Aminejb2002/minihex-9dof-motion-platform/docs/images/cad/exploded_lower_stage.png

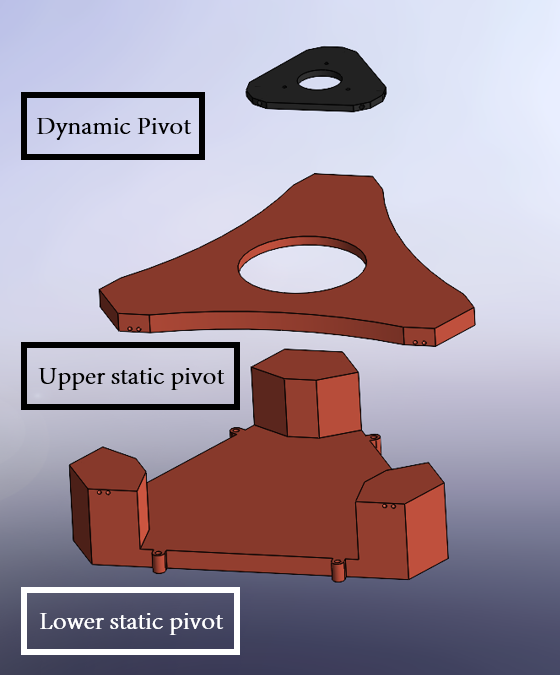
docs/images/cad/exploded_lower_stage.png
