Aminejb2002/minihex-9dof-motion-platform/docs/images/cad/lower_stage.png

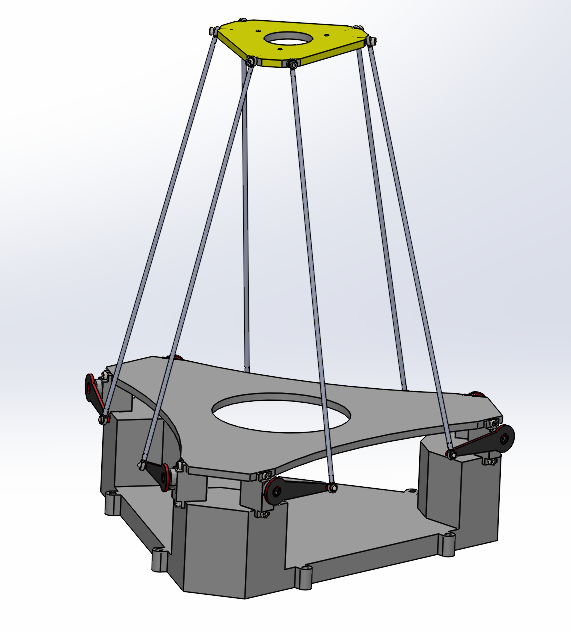
docs/images/cad/lower_stage.png
