Aminejb2002/minihex-9dof-motion-platform/docs/images/cad/servo_orientation_top_view.png

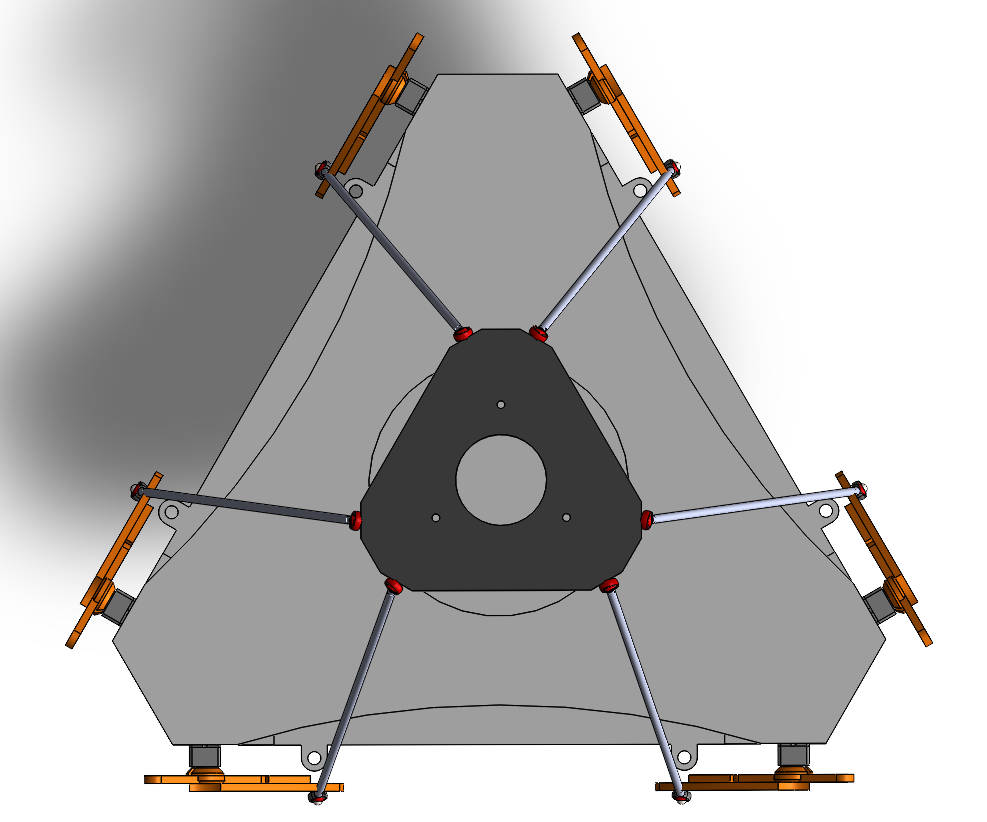
docs/images/cad/servo_orientation_top_view.png
