Aminejb2002/minihex-9dof-motion-platform/docs/images/cad/upper_stage_gimbal.png

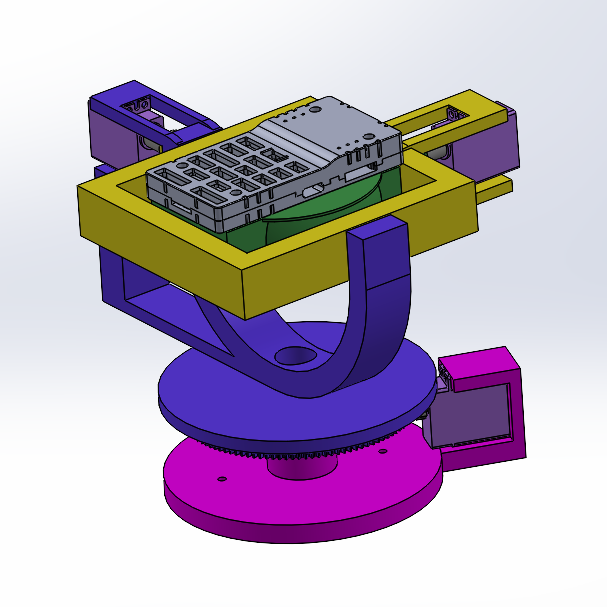
docs/images/cad/upper_stage_gimbal.png
