Aminejb2002/minihex-9dof-motion-platform/docs/images/simulation/rotation_error.png

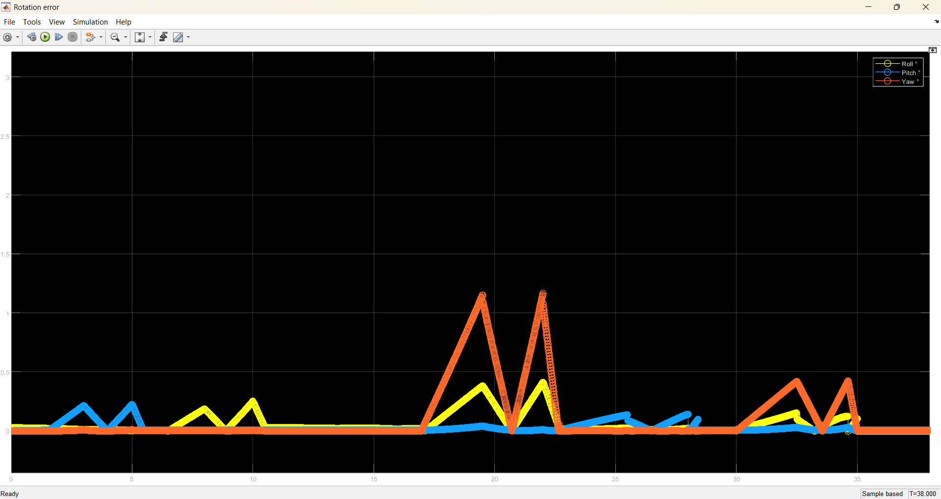
docs/images/simulation/rotation_error.png
