Aminejb2002/minihex-9dof-motion-platform/docs/images/simulation/simscape_full_model.png

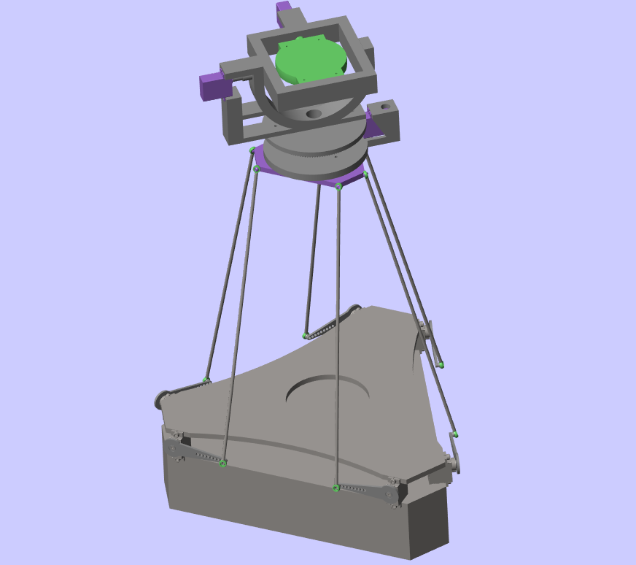
docs/images/simulation/simscape_full_model.png
