Aminejb2002/minihex-9dof-motion-platform/docs/images/simulation/simulink_top_level.png

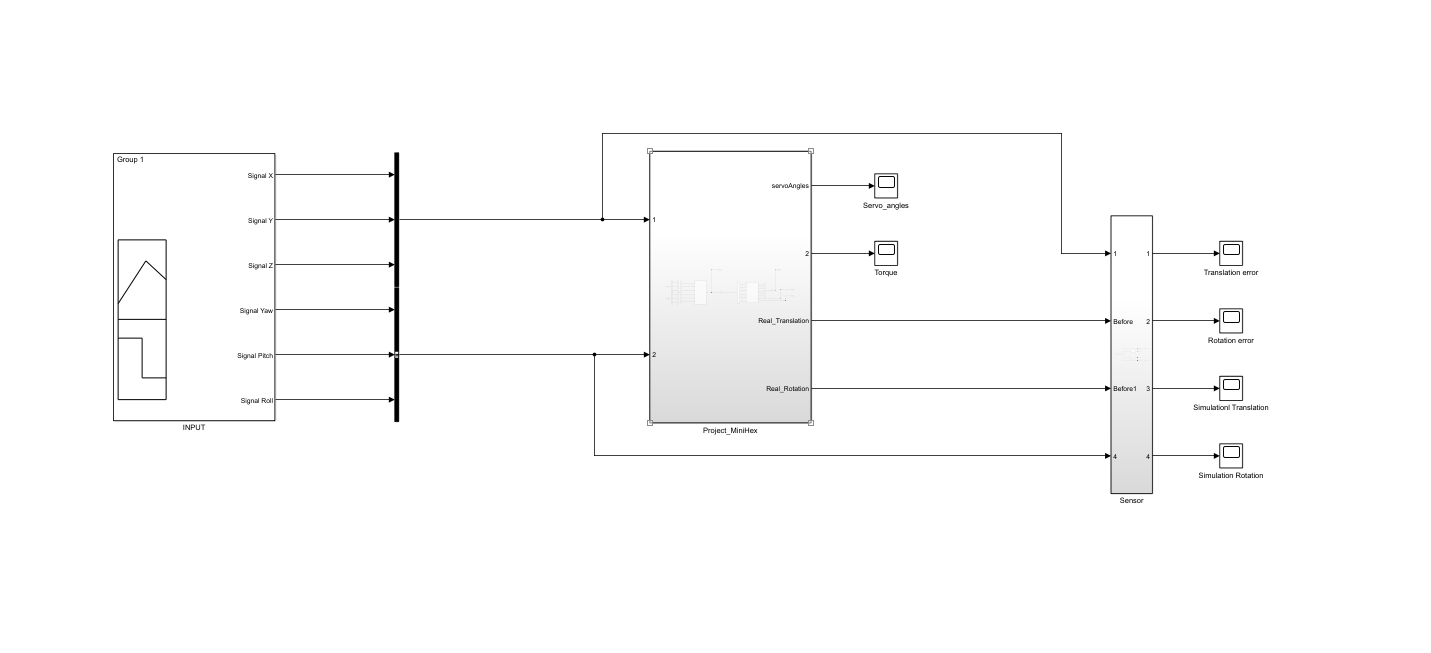
docs/images/simulation/simulink_top_level.png
