Aminejb2002/minihex-9dof-motion-platform/docs/images/simulation/translation_error.png

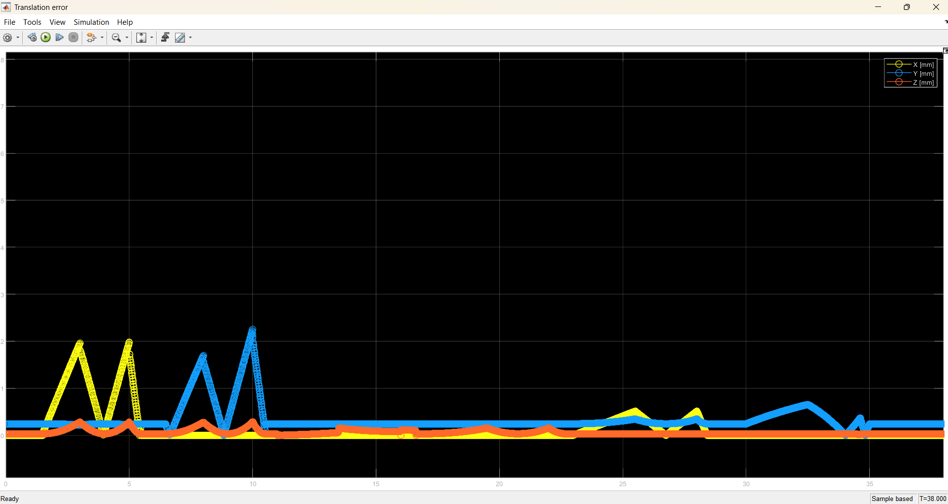
docs/images/simulation/translation_error.png
