Aminejb2002/minihex-9dof-motion-platform/docs/images/simulation/upper_stage_input_signals.png

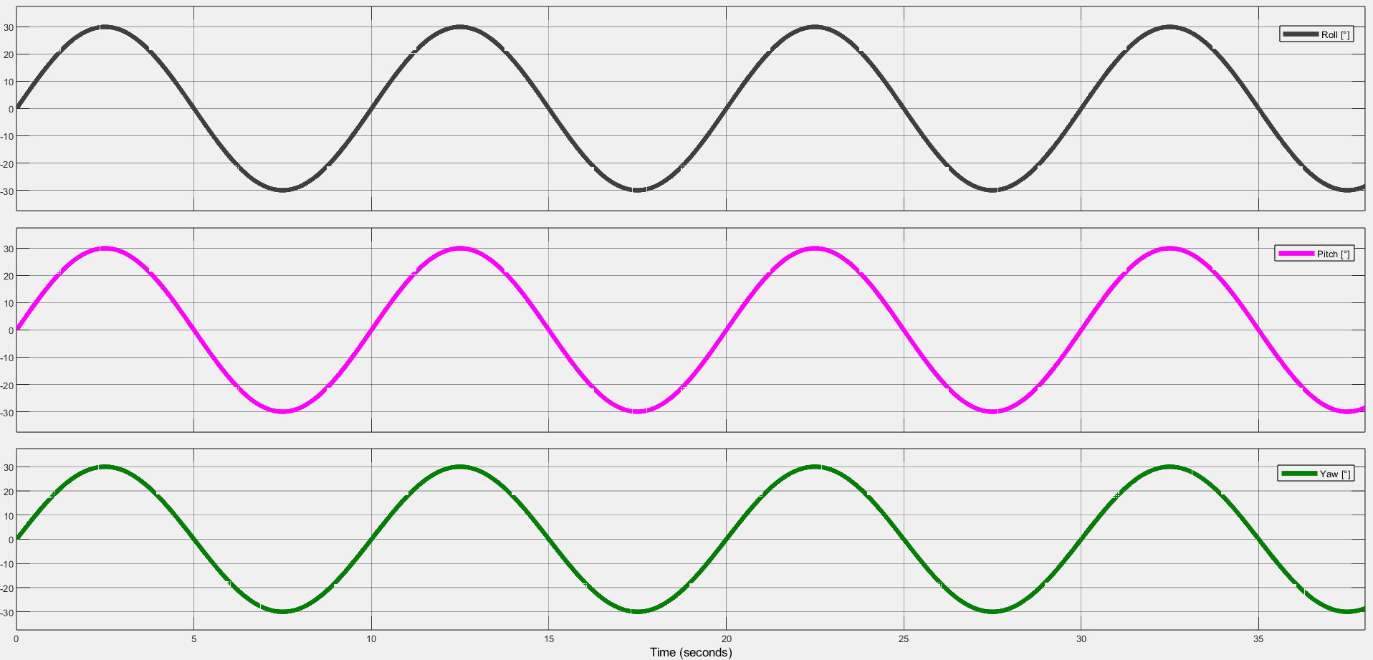
docs/images/simulation/upper_stage_input_signals.png
