Aminejb2002/minihex-9dof-motion-platform/docs/bill_of_parts.md

# Bill of parts

## Lower stage (Stewart platform)

| Part | Qty | Source |
|---|---|---|
| Static pivot, upper part | 1 | 3D printed |
| Static pivot, lower part | 1 | 3D printed |
| Dynamic pivot | 1 | 3D printed |
| Servo horn attachment | 6 | 3D printed |
| Ball joint M3 | 12 | purchased |
| Servo FrSky Xact Mini Servo HV M 5253H | 6 | purchased |
| Rod M3, 300 mm stainless threaded pushrod | 10 | purchased |
| Aluminium servo arm for FrSky Xact servo | 6 | purchased |
| Prusa threaded inserts M2 short | 100 | purchased |
| Prusa threaded inserts M3 standard | 100 | purchased |

## Upper stage (gimbal)

| Part | Qty | Source |
|---|---|---|
| Yaw ring, parts 1 and 2 | 1 each | 3D printed |
| Roll ring | 1 | 3D printed |
| Pitch ring, parts 1 and 2 | 1 each | 3D printed |
| Base plate, parts 1 and 2 | 1 each | 3D printed |
| Small gear for servo | 1 | 3D printed |
| Pixhawk 6C | 1 | purchased |
| Servo FrSky Xact Mini Servo HV M 5252H | 3 | purchased |
| Aluminium servo arm for FrSky Xact servo | 2 | purchased |
| Deep-groove ball bearing 61801 (12 × 21 × 5 mm), optional yaw bearing | 1 | purchased |
| Screws and nuts M2.5 and M3 | 2 each | purchased |

## Design parameters (lower stage)

| Parameter | Value |
|---|---|
| Static pivot diameter | 320 mm |
| Dynamic pivot diameter | 120 mm |
| Rod length | 308 mm |
| Rod diameter | 3 mm |
| Ball joint max. tilt | 20° |

The printable parts are in [`cad/printed_parts`](../cad/printed_parts). Some parts are split into several pieces to fit the print bed and to choose a good print orientation.
