Aminejb2002/minihex-9dof-motion-platform/simulation/simscape/SUB-ASSEMBLY static_pivot_Default_sldprt.STEP

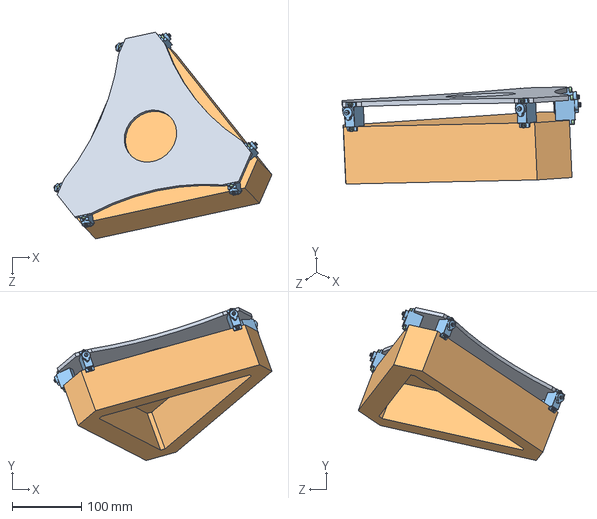
[picture p37: CAD file, 2026-10-01]
simulation/simscape/SUB-ASSEMBLY static_pivot_Default_sldprt.STEP
314.9 x 221.1 x 298.6 mm
