Aminejb2002/minihex-9dof-motion-platform/simulation/simscape/SUB-ASSEMBLY dynamic_pivot_Upper_only_Default_sldprt.STEP

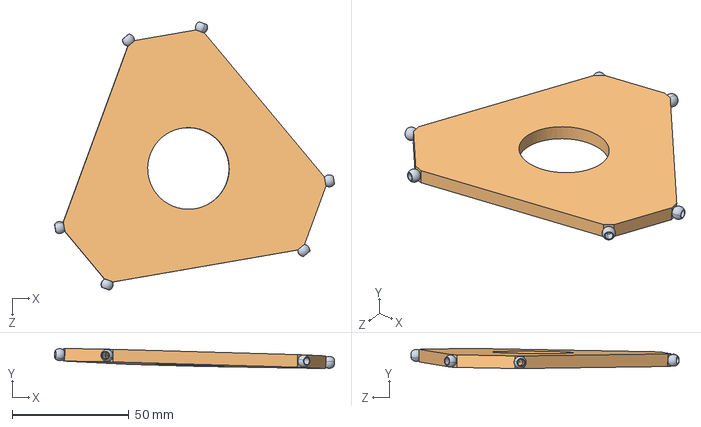
[picture p38: CAD file, 2026-10-01]
simulation/simscape/SUB-ASSEMBLY dynamic_pivot_Upper_only_Default_sldprt.STEP
120.0 x 8.62 x 115.0 mm
