Aminejb2002/minihex-9dof-motion-platform/simulation/simscape/ASSEMBLY_Horn_sphere_Default_sldprt.STEP

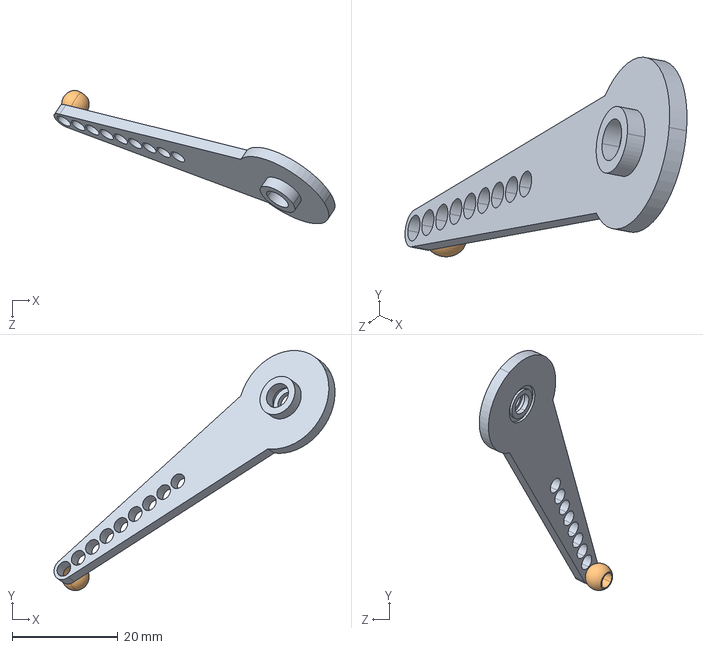
[picture p39: CAD file, 2026-10-01]
simulation/simscape/ASSEMBLY_Horn_sphere_Default_sldprt.STEP
53.1 x 45.4 x 25.2 mm
