Aminejb2002/minihex-9dof-motion-platform/cad/printed_parts/lower_stage/Static_Pivot_Lower_Part.3mf

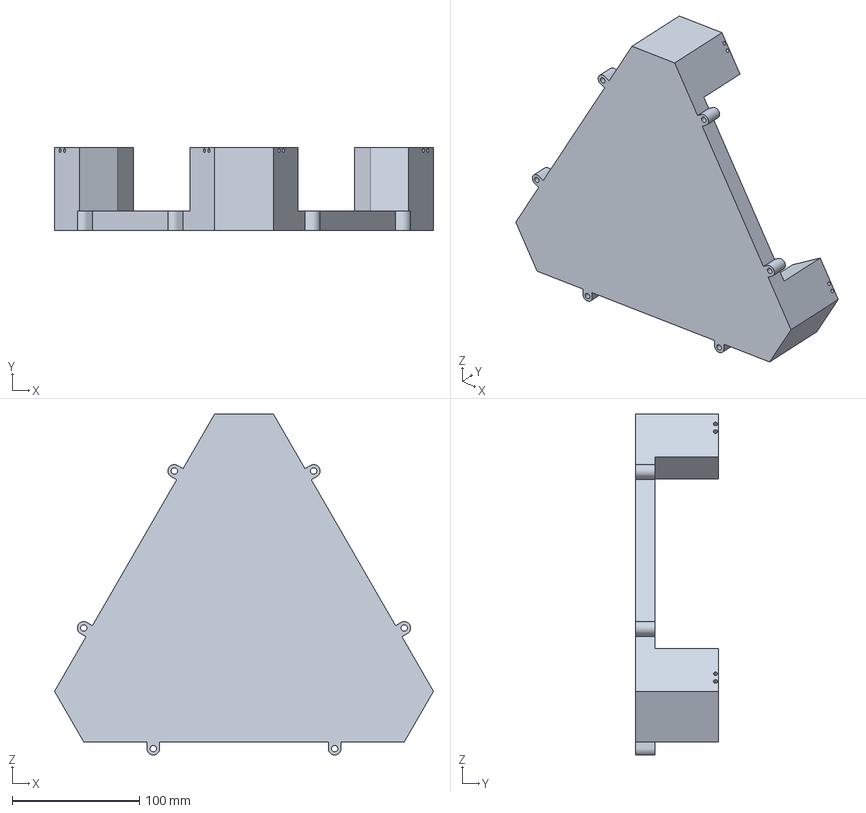
[picture p40: CAD file, 2026-10-01]
cad/printed_parts/lower_stage/Static_Pivot_Lower_Part.3mf
297.3 x 65.4 x 267.4 mm
