Aminejb2002/minihex-9dof-motion-platform/cad/printed_parts/upper_stage/Pitch_Ring_Part_1.3mf

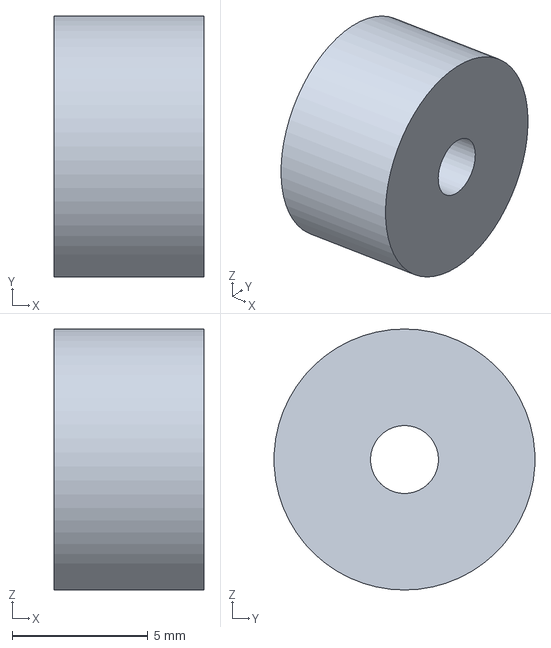
[picture p41: CAD file, 2026-10-01]
cad/printed_parts/upper_stage/Pitch_Ring_Part_1.3mf
5.50 x 9.59 x 9.60 mm
