Aminejb2002/minihex-9dof-motion-platform/cad/solidworks/lower_stage/servo_strong_junk_1.SLDPRT

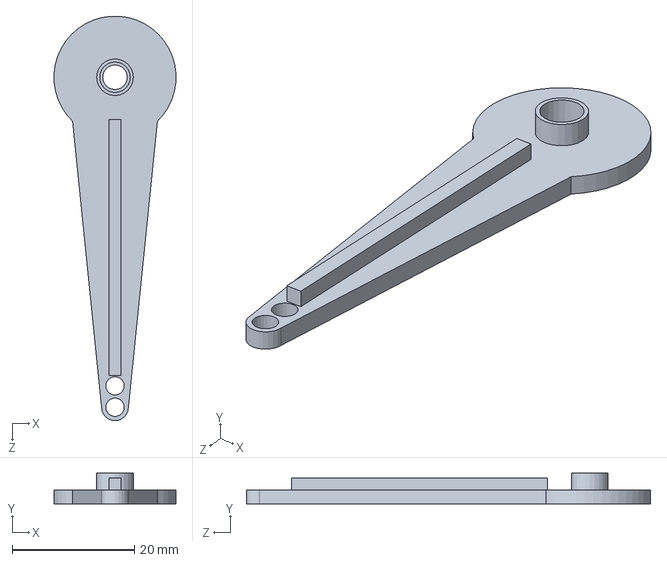
[picture p42: CAD file, 2026-10-01]
cad/solidworks/lower_stage/servo_strong_junk_1.SLDPRT
20.0 x 5.00 x 66.2 mm
