Aminejb2002/minihex-9dof-motion-platform/cad/solidworks/upper_stage/Base_Plate_Part_2.SLDPRT

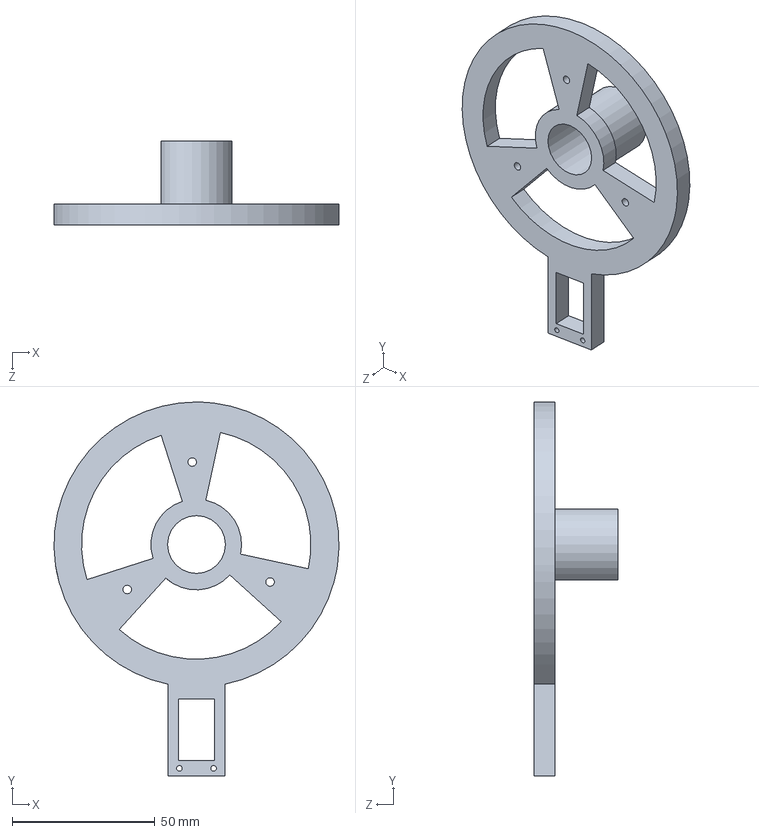
[picture p43: CAD file, 2026-10-01]
cad/solidworks/upper_stage/Base_Plate_Part_2.SLDPRT
100.0 x 131.2 x 29.4 mm
