Aminejb2002/minihex-9dof-motion-platform/cad/printed_parts/lower_stage/Static_Pivot_Upper_Part_Light_Version.3mf

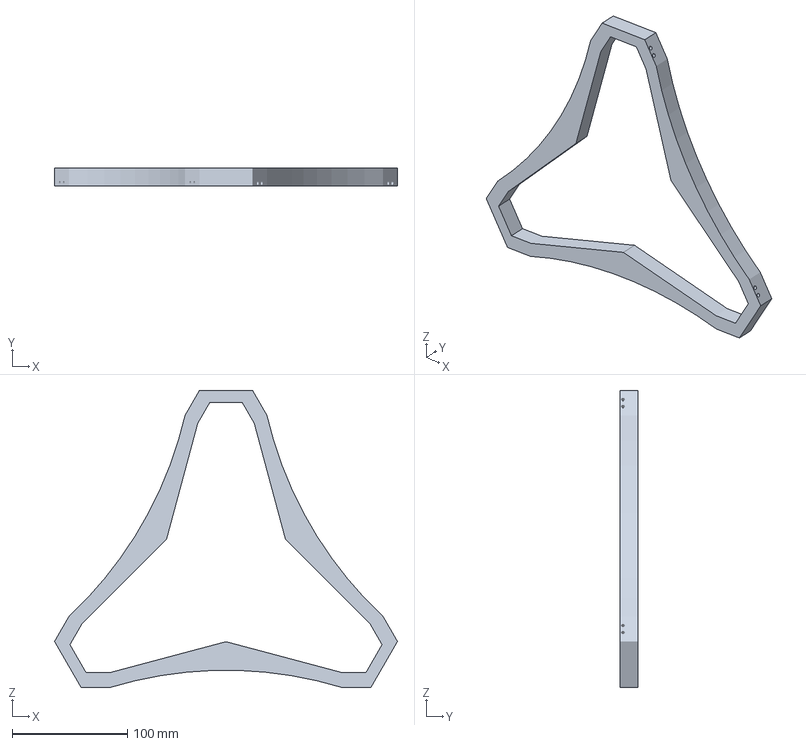
[picture p44: CAD file, 2026-10-01]
cad/printed_parts/lower_stage/Static_Pivot_Upper_Part_Light_Version.3mf
297.3 x 15.4 x 257.5 mm
