Aminejb2002/minihex-9dof-motion-platform/cad/printed_parts/upper_stage/Pitch_Ring_Part_2.3mf

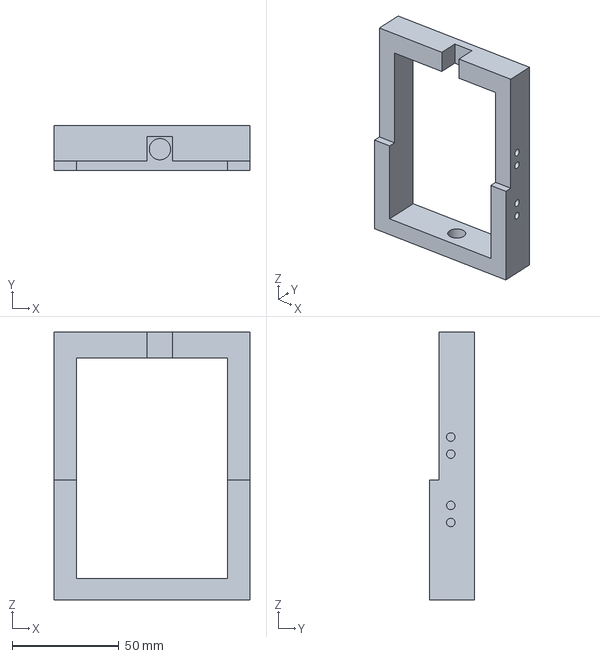
[picture p45: CAD file, 2026-10-01]
cad/printed_parts/upper_stage/Pitch_Ring_Part_2.3mf
91.6 x 21.1 x 125.4 mm
