Aminejb2002/minihex-9dof-motion-platform/cad/solidworks/lower_stage/Dynamic_Pivot.SLDPRT

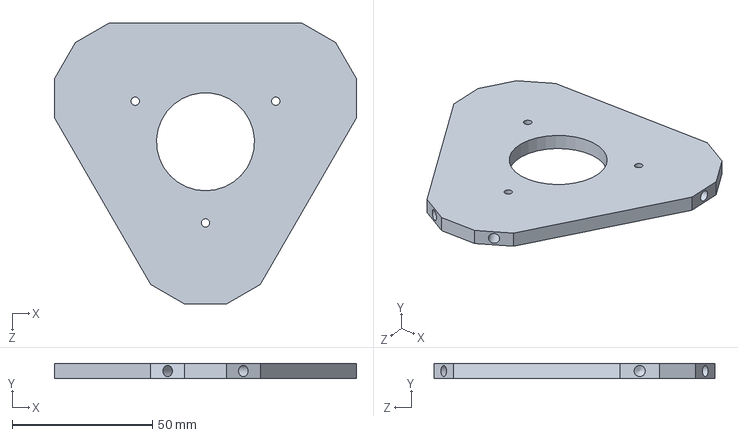
[picture p46: CAD file, 2026-10-01]
cad/solidworks/lower_stage/Dynamic_Pivot.SLDPRT
107.8 x 5.40 x 100.4 mm
