Aminejb2002/minihex-9dof-motion-platform/simulation/simscape/IMU-PIXHAWK6C.stp_Default_sldprt.STEP

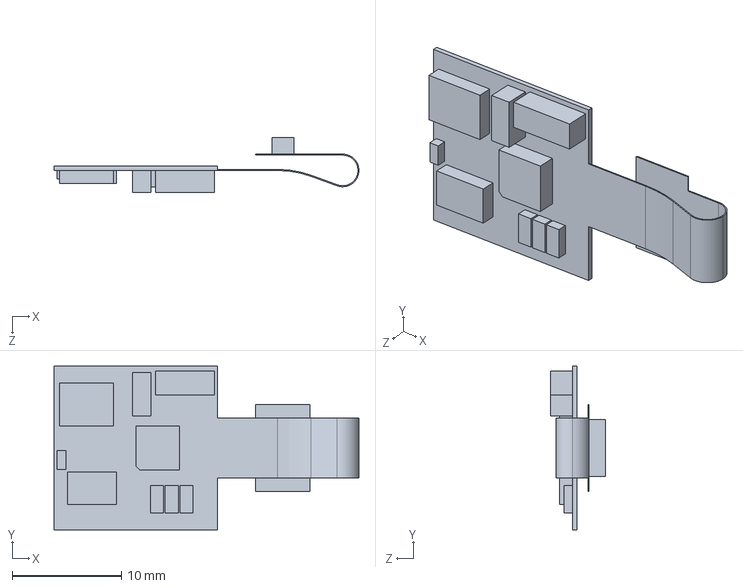
[picture p47: CAD file, 2026-10-01]
simulation/simscape/IMU-PIXHAWK6C.stp_Default_sldprt.STEP
28.0 x 15.0 x 5.00 mm
