Aminejb2002/minihex-9dof-motion-platform/cad/printed_parts/upper_stage/Roll_Ring.3mf

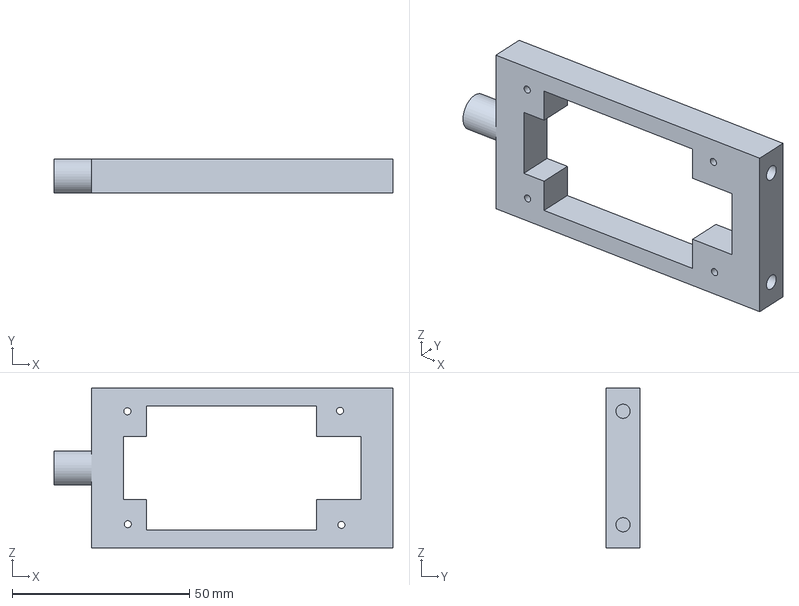
[picture p48: CAD file, 2026-10-01]
cad/printed_parts/upper_stage/Roll_Ring.3mf
95.6 x 9.60 x 45.0 mm
