Aminejb2002/minihex-9dof-motion-platform/cad/solidworks/lower_stage/Static_Pivot_Upper_Part.SLDPRT

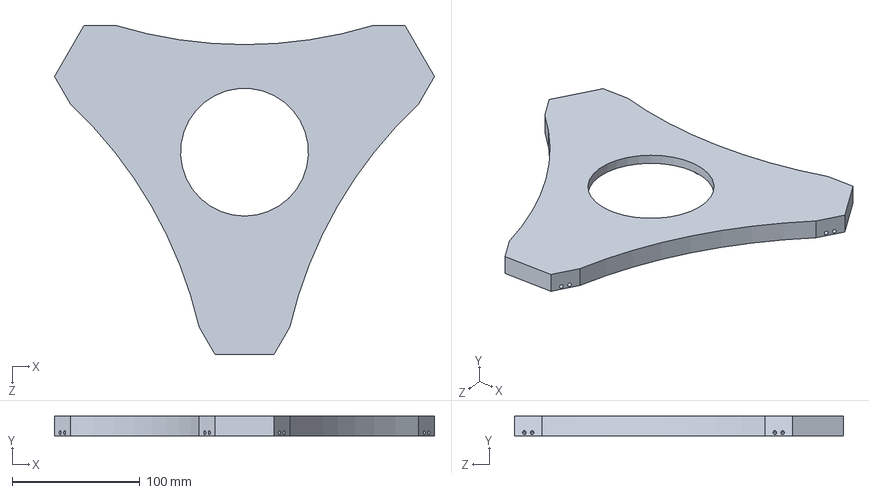
[picture p49: CAD file, 2026-10-01]
cad/solidworks/lower_stage/Static_Pivot_Upper_Part.SLDPRT
297.3 x 15.4 x 257.5 mm
