Aminejb2002/minihex-9dof-motion-platform/simulation/simscape/MIANKE-PIXHAWK6C-LV-C1.stp_Default_sldprt.STEP

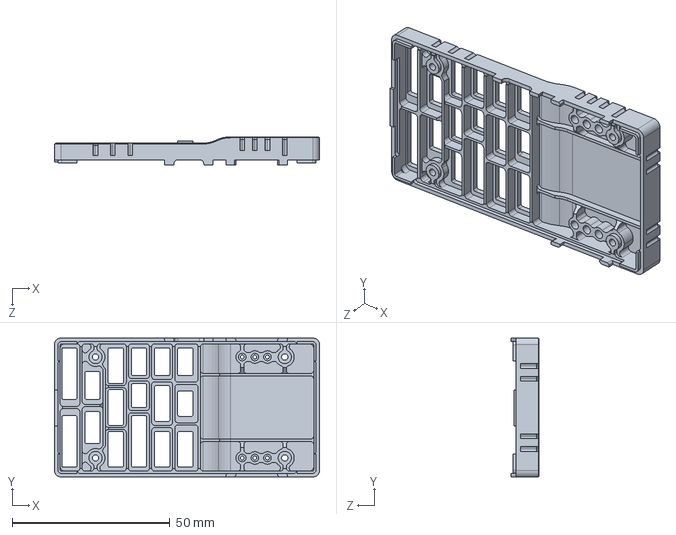
[picture p50: CAD file, 2026-10-01]
simulation/simscape/MIANKE-PIXHAWK6C-LV-C1.stp_Default_sldprt.STEP
84.0 x 44.0 x 9.00 mm
