Aminejb2002/minihex-9dof-motion-platform/cad/solidworks/upper_stage/Yaw_Ring_Part_1.SLDPRT

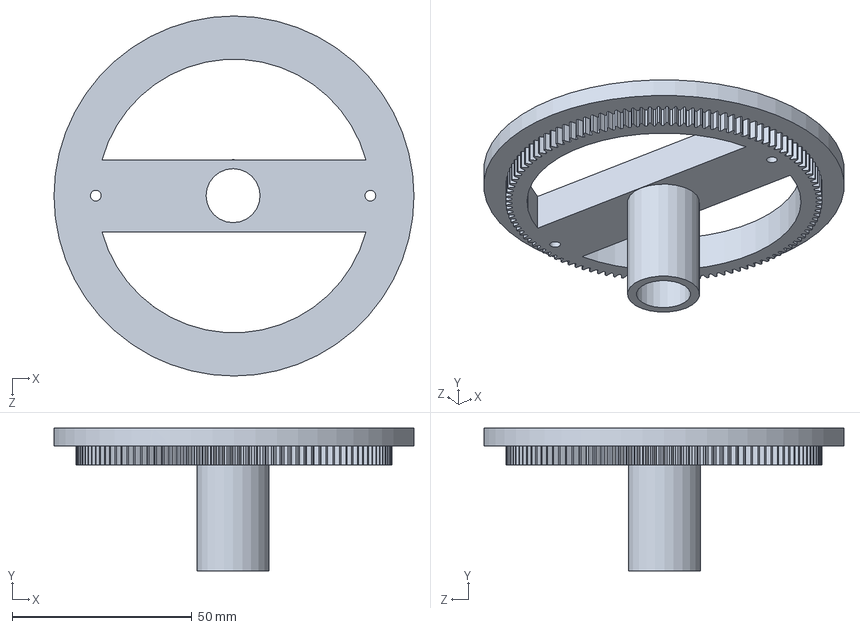
[picture p51: CAD file, 2026-10-01]
cad/solidworks/upper_stage/Yaw_Ring_Part_1.SLDPRT
100.0 x 39.6 x 100.0 mm
