Aminejb2002/minihex-9dof-motion-platform/simulation/simscape/Ball Joint 3mm outer sphere_Default_sldprt.STEP

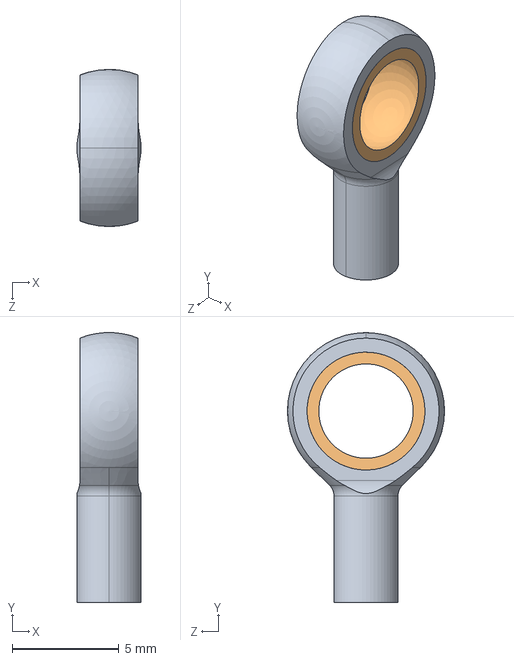
[picture p52: CAD file, 2026-10-01]
simulation/simscape/Ball Joint 3mm outer sphere_Default_sldprt.STEP
3.02 x 12.7 x 7.36 mm
