Aminejb2002/minihex-9dof-motion-platform/cad/printed_parts/lower_stage/Horn_Attachment.3mf

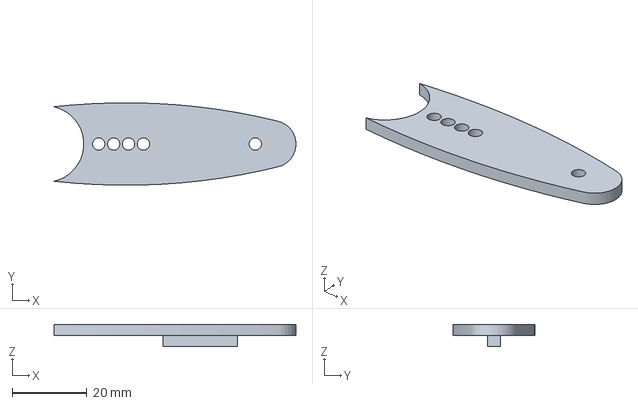
[picture p53: CAD file, 2026-10-01]
cad/printed_parts/lower_stage/Horn_Attachment.3mf
64.9 x 22.1 x 6.00 mm
