Aminejb2002/minihex-9dof-motion-platform/cad/printed_parts/upper_stage/Yaw_Ring_Part_2.3mf

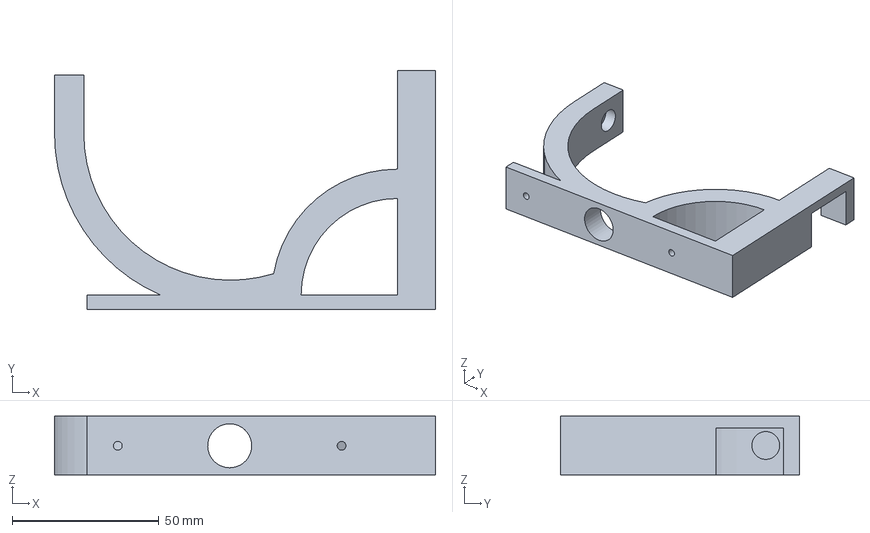
[picture p54: CAD file, 2026-10-01]
cad/printed_parts/upper_stage/Yaw_Ring_Part_2.3mf
129.9 x 81.5 x 20.0 mm
