Aminejb2002/minihex-9dof-motion-platform/simulation/simscape/Roll_Ring_Backup_Version_Default_sldprt.STEP

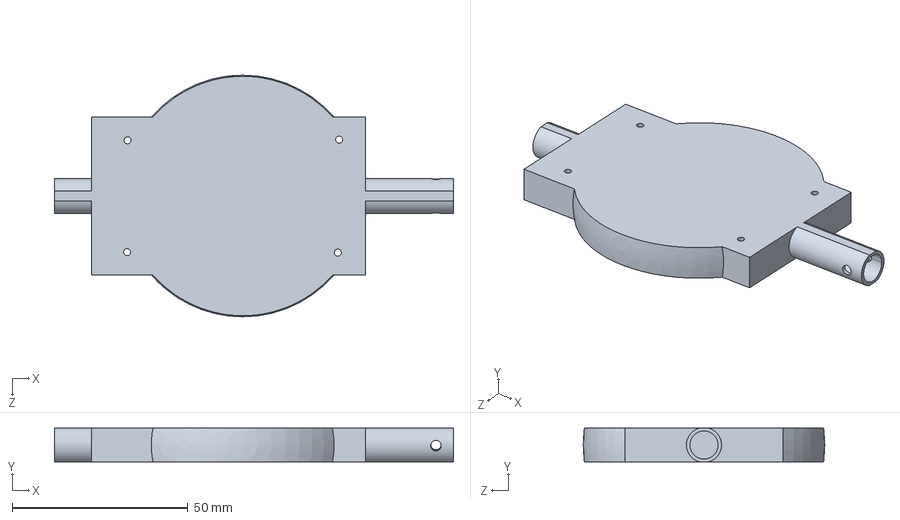
[picture p55: CAD file, 2026-10-01]
simulation/simscape/Roll_Ring_Backup_Version_Default_sldprt.STEP
113.6 x 9.60 x 68.8 mm
