Aminejb2002/minihex-9dof-motion-platform/cad/printed_parts/upper_stage/Base_Plate_Part_1.3mf

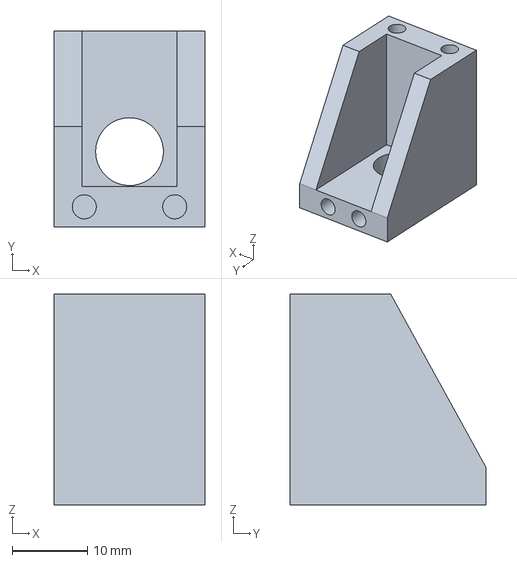
[picture p56: CAD file, 2026-10-01]
cad/printed_parts/upper_stage/Base_Plate_Part_1.3mf
20.0 x 26.0 x 28.0 mm
