Aminejb2002/minihex-9dof-motion-platform/simulation/simscape/PCB-PIXHAWK6C-F1.stp_Default_sldprt.STEP

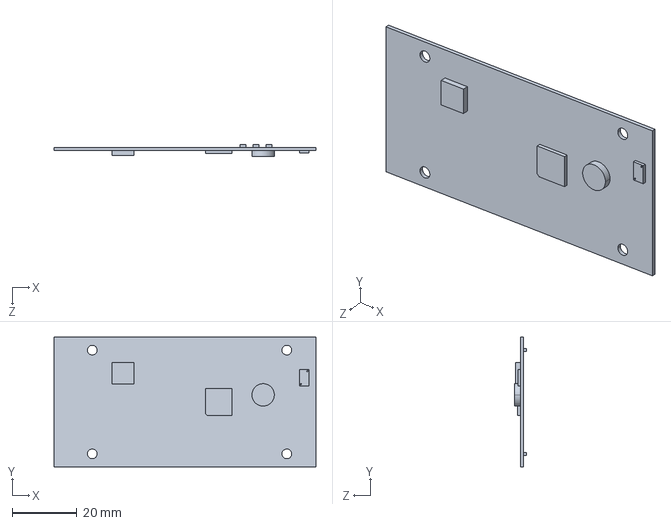
[picture p57: CAD file, 2026-10-01]
simulation/simscape/PCB-PIXHAWK6C-F1.stp_Default_sldprt.STEP
80.8 x 40.0 x 3.60 mm
