Aminejb2002/minihex-9dof-motion-platform/simulation/simscape/Base Plate_Default_sldprt.STEP

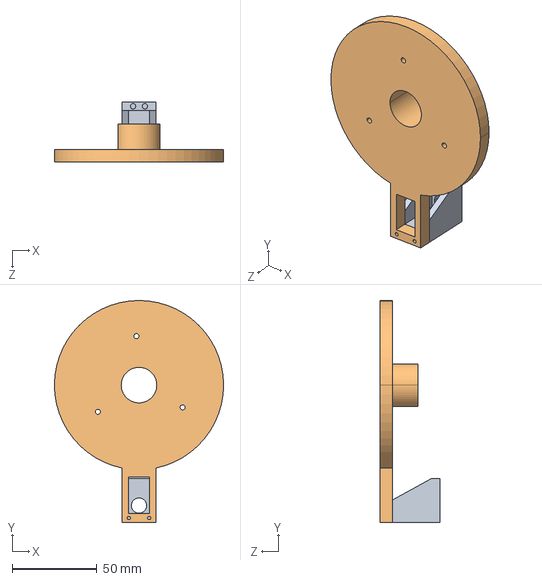
[picture p58: CAD file, 2026-10-01]
simulation/simscape/Base Plate_Default_sldprt.STEP
100.0 x 131.2 x 35.4 mm
