Aminejb2002/minihex-9dof-motion-platform/simulation/simscape/Pitch_Ring_Default_sldprt.STEP

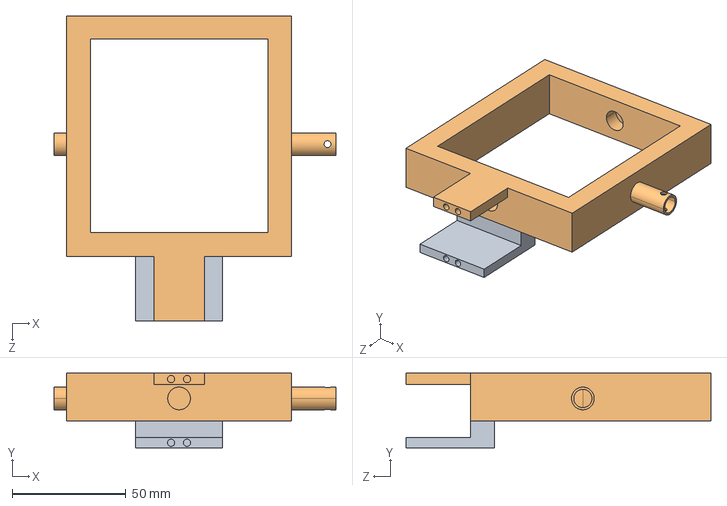
[picture p59: CAD file, 2026-10-01]
simulation/simscape/Pitch_Ring_Default_sldprt.STEP
124.0 x 32.8 x 134.0 mm
