Aminejb2002/minihex-9dof-motion-platform/simulation/simscape/small Gear_Servo__Default_sldprt.STEP

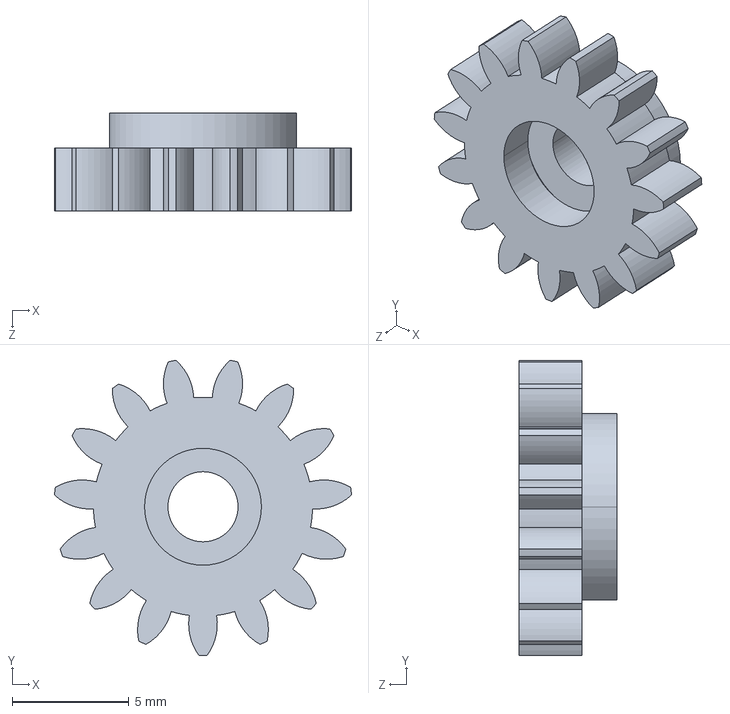
[picture p60: CAD file, 2026-10-01]
simulation/simscape/small Gear_Servo__Default_sldprt.STEP
12.7 x 12.6 x 4.20 mm
