Aminejb2002/minihex-9dof-motion-platform/simulation/simscape/Xact Mini Servo HV M 5252H_Default_sldprt.STEP

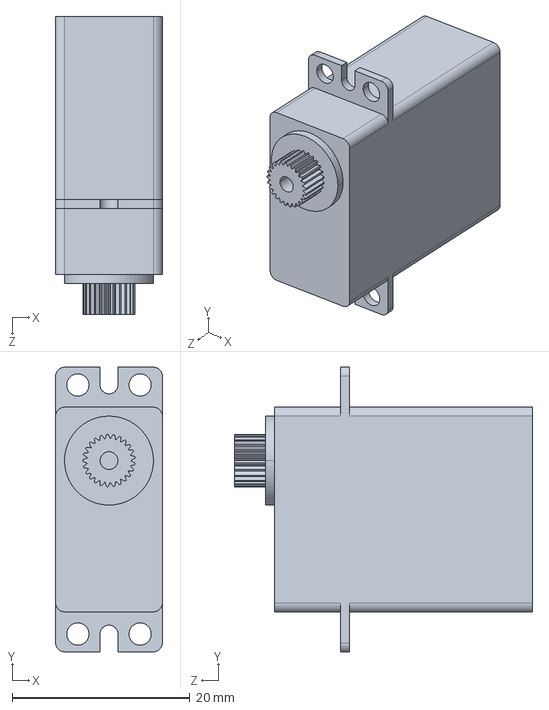
[picture p61: CAD file, 2026-10-01]
simulation/simscape/Xact Mini Servo HV M 5252H_Default_sldprt.STEP
12.0 x 32.0 x 33.5 mm
