Aminejb2002/minihex-9dof-motion-platform/simulation/simscape/Rod_Default_sldprt.STEP

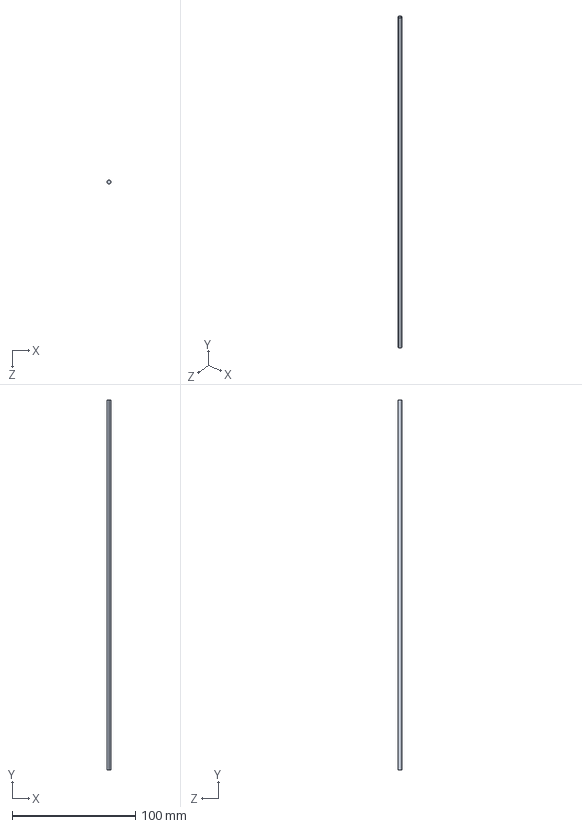
[picture p62: CAD file, 2026-10-01]
simulation/simscape/Rod_Default_sldprt.STEP
3.20 x 300.0 x 3.20 mm
