Aminejb2002/minihex-9dof-motion-platform/simulation/simscape/Yaw_Ring_Default_sldprt.STEP

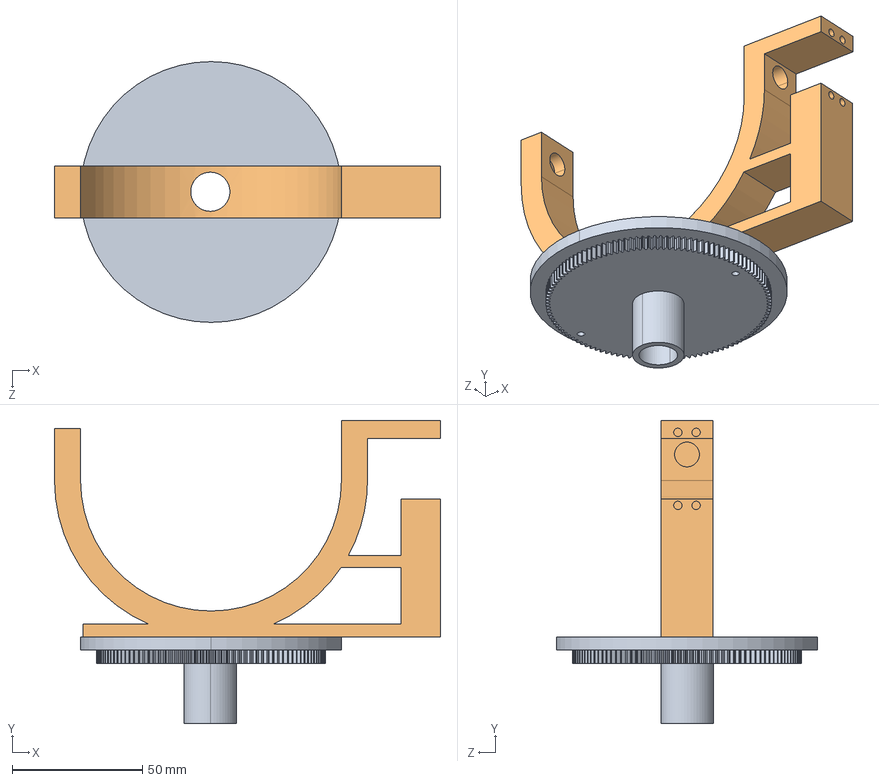
[picture p64: CAD file, 2026-10-01]
simulation/simscape/Yaw_Ring_Default_sldprt.STEP
148.0 x 116.3 x 100.0 mm
