Aminejb2002/minihex-9dof-motion-platform/(list of files, cad)

Other CAD files:
cad/solidworks/upper_stage/Pitch_Ring_Part_2.SLDPRT
cad/printed_parts/lower_stage/servo_strong_junk_1_New_Version.3mf
cad/solidworks/upper_stage/Pitch_Ring_Part_1.SLDPRT
cad/printed_parts/lower_stage/Dynamic_Pivot.3mf
cad/printed_parts/upper_stage/Base_Plate_Part_2.3mf
cad/solidworks/lower_stage/Static_Pivot_Lower_Part.SLDPRT
cad/solidworks/lower_stage/Horn_Attachment.SLDPRT
cad/solidworks/upper_stage/New_Roll_Ring.SLDPRT
cad/printed_parts/upper_stage/Yaw_Ring_Part_1.3mf
cad/solidworks/upper_stage/Yaw_Ring_Part_2.SLDPRT
cad/solidworks/upper_stage/Base_Plate_Part_1.SLDPRT
simulation/simscape/Screw_Default_sldprt.STEP
simulation/simscape/hex thin nut gradeb_din_Hexagon Nut ISO 4036 - M3 - N_sldprt.STEP
simulation/simscape/pan head cross recess screw_din_DIN EN ISO 7045 - M2.5 x 12 - Z - 12N_sldprt.STEP
