Aminejb2002/minihex-9dof-motion-platform/docs/images/cad/servo_horn_rod_assembly.png

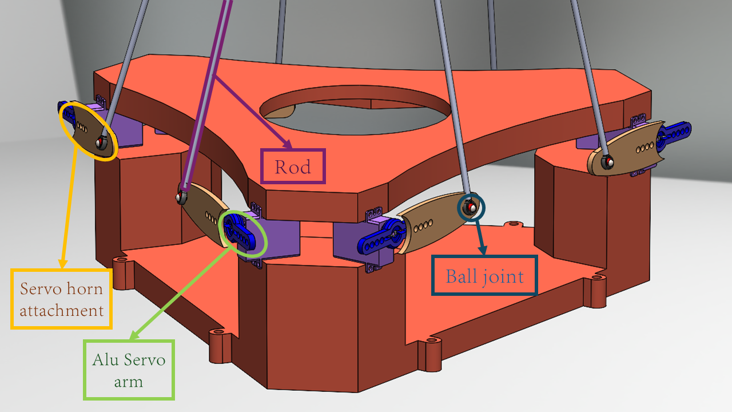
docs/images/cad/servo_horn_rod_assembly.png
