Aminejb2002/minihex-9dof-motion-platform/docs/images/design_iterations/upper_redesign_after_print.png

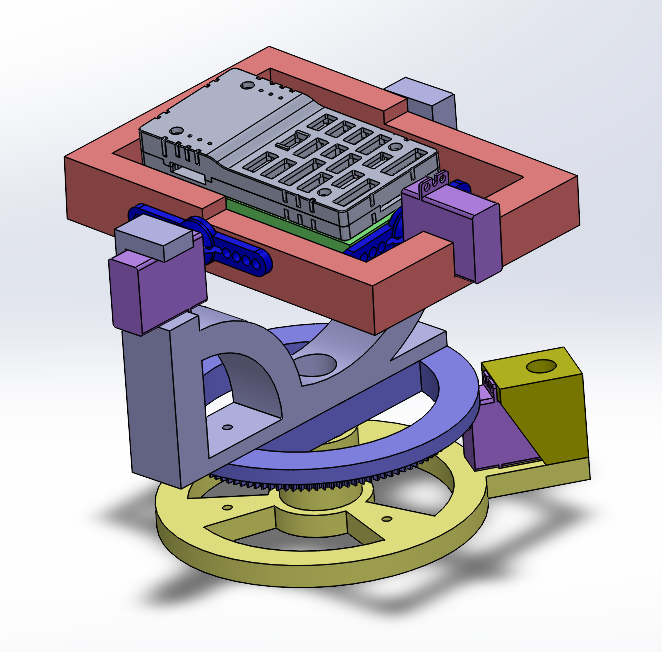
docs/images/design_iterations/upper_redesign_after_print.png
